knopjesmuseum/resilient-network/pcb/PI_E680997.pdf

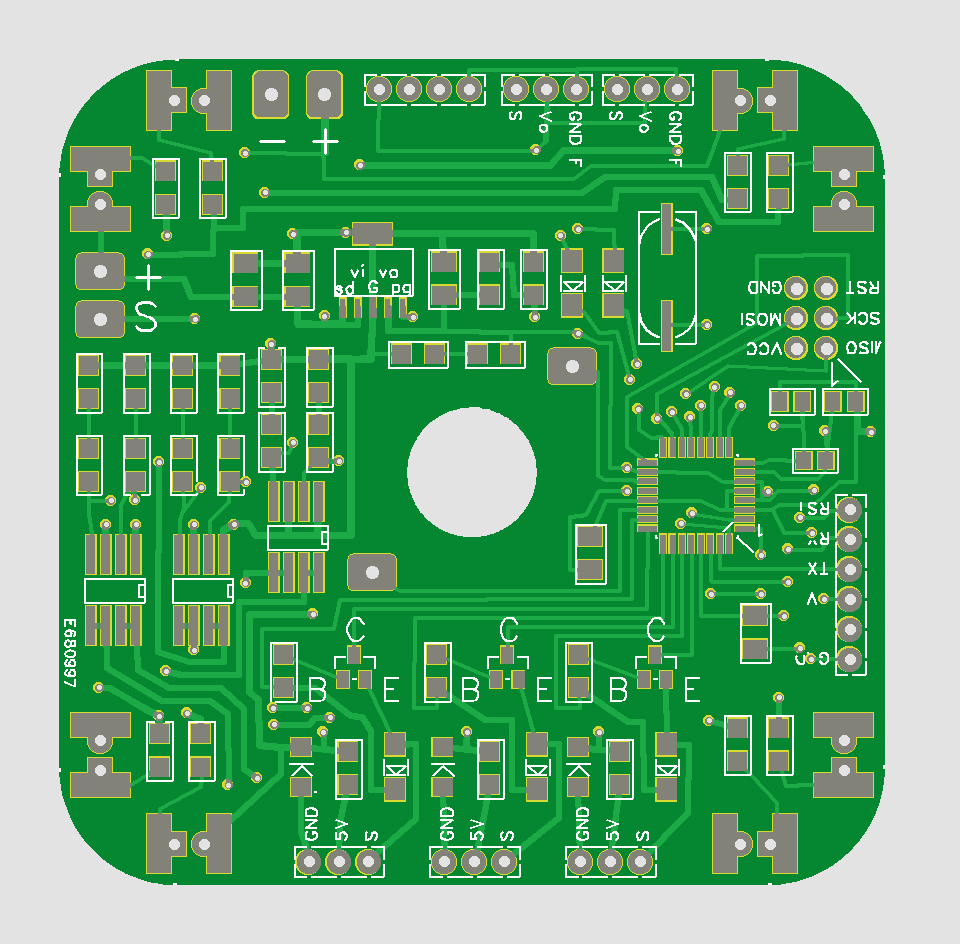
[picture p2: page 1]

E680997 PCB view TOP (topview)

E680997 TOP layer Image (topview)

E680997 BOTTOM layer Image (topview)

E680997 PCB view BOTTOM (bottomview)

# E680997 PCB Mechanical view (topview)

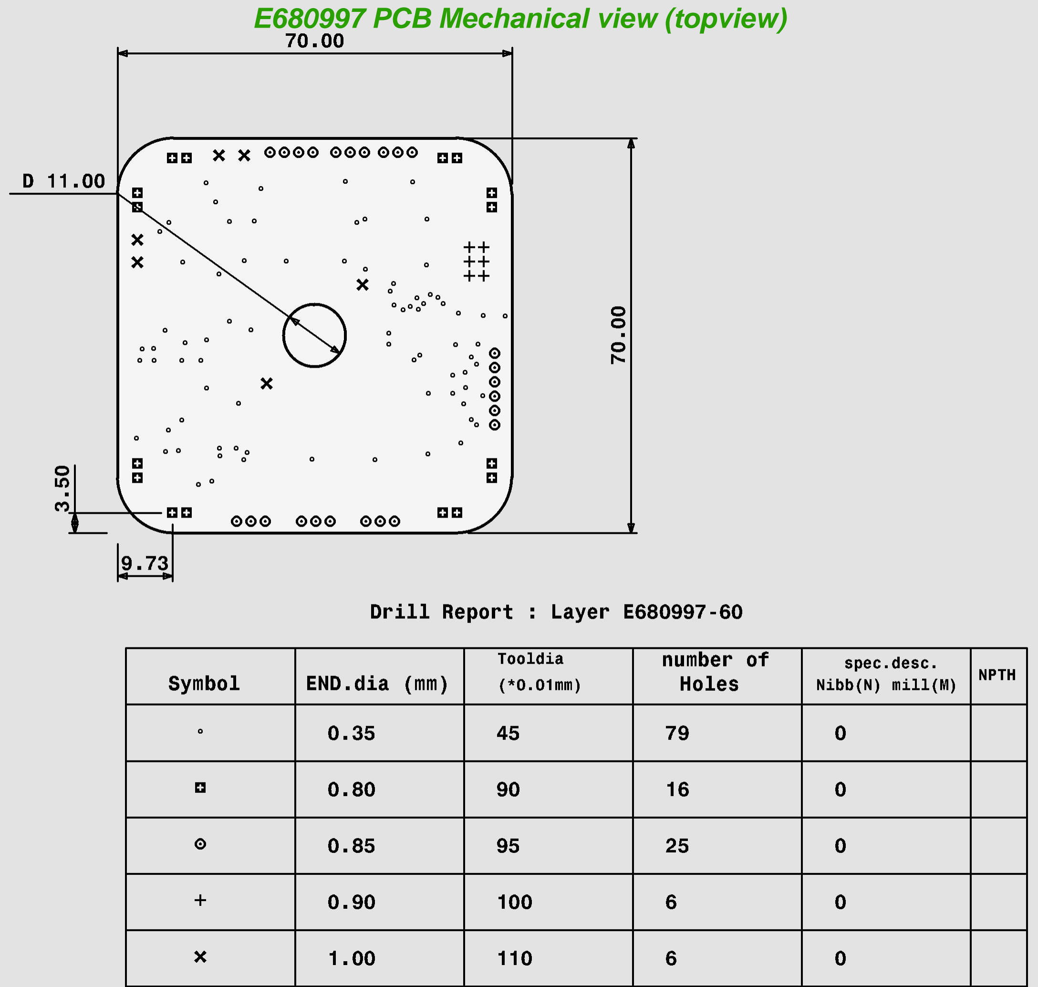
[picture p3: page 5]
