knopjesmuseum/resilient-network/pcb/atmega328-tqfp-arduino-pinout.jpg

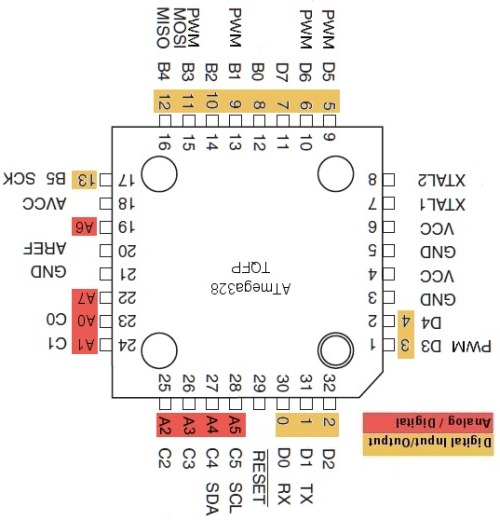
pcb/atmega328-tqfp-arduino-pinout.jpg
