knopjesmuseum/resilient-network/(threads)

Thread 1 (2015-12-28):

Multi listen fails

peteruithoven, 2015-12-28:
Currently the blocking issue is making the node’s listen to 3 (software serial) ports at the same time. In the SoftwareSerialWithHalfDuplex-experiments folder the 3th experiment almost always fails, sometimes a message get’s received (indicated by the led), but it’s never echoed back to the sender.

**Low level pre-check**
One solution might be to add a very fast, but low lever pre-check, when one of the porst is pulled high we start listening to that port with the softwareserial library. With this approuch it’s imperitive that the library responds quick enough without losing data. A slower baudrate might help.

**Send queue**
Another solution would be to create a send buffer and acknowledgment system. The sending party would attempt to send a message and waits (with timeout) to receive an acknowledment. When this isn't received it should try again after a random timeout. Because it might have attempted to send another message in the mean time, a queue might be necessary. The old Resilient Network code contianed a lot of this logic, but it wasn't very successful in the end.

**Other library**
There is at least one other library that should do the same, maybe it has a better solution?
http://hackaday.com/2014/01/13/software-half-duplex-uart-for-avrs/
http://nerdralph.blogspot.ca/2014/01/avr-half-duplex-software-uart.html
https://github.com/nerdralph/nerdralph/blob/master/avr/libs/bbuart/

**Other IC (hardware)**
The regular Atmega 328p (also used in Arduino Uno) has (only) two interrupt pins. Having 3 or more would significantly simplify the problem. There are other Arduino projects with more interrupts pins, like the ATmega2560 (Arduino mega) and ATmega32u4 (Arduino Micro), see:
https://www.arduino.cc/en/Reference/AttachInterrupt.
The [Teensy 3.2](https://www.sparkfun.com/products/13736) has interrupts on all ports, I can't find information on interrups for the [Teensy LC](https://www.sparkfun.com/products/13305).

peteruithoven, 2016-01-03:
After fixing the [Half duplex software serial issue](https://github.com/knopjesmuseum/resilient-network/issues/2) and learning how to [directly read pins](https://github.com/knopjesmuseum/resilient-network/blob/master/experiments/DirectRead/DirectRead.ino) we've made great strides in the Low level pre-check approach. See the following experiment:
https://github.com/knopjesmuseum/resilient-network/tree/master/experiments/SoftwareSerial/3%20multi-read-precheck
Part B resends what it receives from normal serial to 3 half duplex software serial ports. Part A reads all it's software serial ports and and per port toggles a led when it receives messages. It seems to work 100%.
Next we should also try sending and maybe adding another node.

Solution *3. Simultaneous receive*, still is a very interesting approach, but requires writing a different SoftwareSerial library.

peteruithoven, 2016-01-03:
With the old approach i created the following two tests, they might be interesting to repeat:
- https://www.youtube.com/watch?v=h-U3dGAMmZ0
- https://www.youtube.com/watch?v=wtsAdg91zGs

peteruithoven, 2016-01-31:
With the **1. Low level pre-check** approach we seem to have good results so far, with a baudrate of about 9600.

Thread 2 (2016-01-02):

Update Software Serial

peteruithoven, 2016-01-02:
Currently we use a SoftwareSerial fork with some tweaks to allow half duplex communication, but this was last changed in 2012. I would like to use the latest SoftwareSerial, so I've done a pull request for half duplex support:
https://github.com/arduino/Arduino/pull/4377

peteruithoven, 2016-01-03:
After doing some research I understand that the circuit we use (see below) makes that software half duplex feature redundant. The regular SoftwareSerial didn't work because we switched the rx and tx pins...
https://github.com/knopjesmuseum/resilient-network/blob/master/pcb/half-duplex-circuit.png

We can now use the regular SoftwareSerial (without having to enable the inverse logic).

Closed 2016-01-03.
