knopjesmuseum/resilient-network/(commit log)

2015-12-28 Some pcb information
2015-12-28 More led information
2015-12-28 pcb clarifications
2015-12-28 Include unused second button
2015-12-28 pcb readme update
2015-12-28 Button fix
2016-01-03 Added half duplex circuit
2016-01-03 White background behind circuit
2016-01-03 Fixed SoftwareSerial simple experiment
    To not require software fix for doing half-duplex
    [SoftwareSerial_test_PartA.ino, SoftwareSerial_test_PartB.ino]
2016-01-04 PCB read me update
2016-01-28 Read write experiment: toggle big leds
    Because not al boards have the smaller debug leds
2016-01-30 Only forward dropping when in alert mode
    Preventing this message to never be stopped being send around
    [resilient-network.ino]
2016-01-30 Moved files for get Arduino IDE working again & read isSource from pin
2016-01-30 Improve & fix serial debug
    [resilient_network.ino]
2016-01-30 ProcessEnergy on fixed interval
    [resilient_network.ino]
